AtomicRoland/BeebWiFi/doc/BeebWifi-UserManual.odt

BBC Micro WiFi

User Manual

Roland Leurs

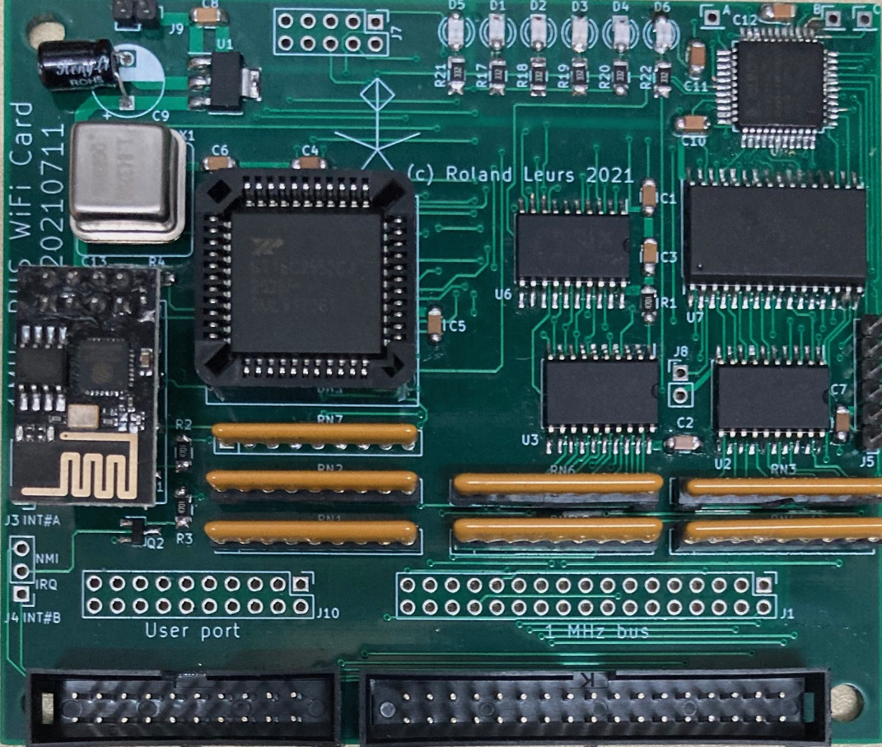
[picture p1: figure]

Copyright (c) 2021 - 2023 Roland Leurs

September 2023

# Introduction

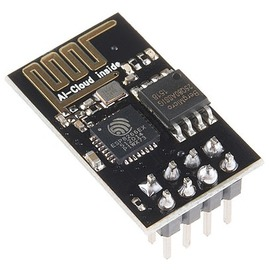
[picture p2: figure]

The ESP8266-01 is (literally) a small device with great possibilities. It enables classic computers and modern micro-controllers to connect to a WiFi network and transmit data via a simple serial interface. Just like bitd it accepts a set of AT commands and performs the necessary actions that are needed for the network communication. The device holds a complete TCP/IP stack, albeit IPv4 only.

So all you need to connect to a wireless network is just a standard serial interface, an ESP8266 and some software.

When I started this project on my Acorn Atom I used the serial port of the Godil and although it basically worked, data transfers were mostly not completed. I never figured out what the reason was, I still suspect my first ESP module (which was another type) was not quite good.

I decided to start a new project with another, even smaller, device (the one you see in the picture above) and I also added an extra serial device. For my Atom 2k18 I could use some additional serial ports since it needs one for communicating with the on-board Pi-Zero and now also for the WiFi device. I picked the 16C2552 which is a dual UART (Universal Asynchronous Receiver and Transmitter) which has two independent communication channels, a 16 byte input / output buffer (FIFO, first in first out) and can transmit up to 4 Mbps. And most important: it is affordable and available from reliable suppliers.

For the Atom I wrote a WiFi driver which can be used by user applications and commands. A basic set of commands include LAP (list access points), JOIN (join a network), TIME/DATE and WGET (to download a file from a web server). All these commands use the same driver. And this setup works nice.

About the time I finished this project the question “Acorn Electron online – any such hardware” popped up on the StarDot forum. And as I had such hardware and software for the Atom, I decided to port both to the Electron. The board was a great success and soon the request for a BBC (Master) version arose. After finishing most of the software for the Elk WiFi I started to work on a version that connects to the 1 MHz bus of the BBC Micro.

So here it is, the Beeb WiFi module. An easy to install and use board to connect your BBC Micro to the Internet. I hope you enjoy this device as much as I do.

# WARNINGS

Before I continue I have some important warnings:

### 1. Security

The BBC Micro is in no way a secure device, nor is the software for the WiFi module. When using the commands or driver, usernames and passwords may be kept in memory.

### 2. Baud rate changes may brick the ESP8266

The default transmission speed for the ESP8266 is 115,200 baud. Both the Atom and the BBC Micro can handle data transfers at this speed. Do not try to change this speed because the ESP8266 might accept your command but does not always perform it correctly. You might end up with a module that communicates at an unknown serial speed. The only remedy to fix that is to flash the device (or replace it, after all, they cost only about £1.00).

### 3. Only for personal, domestic use

Both the hardware and software are not designed for medical- and health use nor for mission critical, industrial and automotive purposes. Use it at your own risk.

# Hardware description

The complete diagram is included at appendix I. I will describe my design considerations and the components in this chapter.

### Design considerations

There were two options to make the WiFi board available to the BBC Micro:

1. Create an interface board that creates an Electron compatible slot for the Beeb.
2. Design a complete new board with the same core components.

Since the 1 MHz bus does not support sideways memory the ROM should always be installed on the main board or loaded from disc into sideways RAM. To meet the technical requirements of the 1 MHz bus, the first option adds extra costs to the WiFi connection. So I decided to make a new board that directly connects to the 1 MHz bus.

The same core components are used as in the Electron version:

- ESP8266 WiFi module
- 16C2552 Dual Channel UART
- 128 kB RAM
- Xilinx XC9572XL CPLD for logic
  The paged RAM register should be both writable and readable. I could do this by adding an extra buffer that is enabled when a read cycle occurs at &FCFF (the address of the paged RAM register). But the UART has two scratch pad registers. These behave like a normal memory address. So I use the scratch

pad register of the A-channel (which is available for generic serial applications) as a read/write copy of the paged RAM register. The decoding is simply done in hardware so for a programmer the address &FCFF is just a normal register that can be written and read.

If your BBC Micro already has paged RAM at &FDxx then you can disable the memory on the WiFi board by adding a jumper.

To use the full 128kB of the RAM I connected the Multi Function B output of the serial port to address line A16 of the RAM.

### Circuit description

The circuit has the following blocks:

1. Power supply The board gets its +5V from either the User Port (a connector is provided on the board) or you can connect an external power supply to J9. Only the power lines of the User Port are connected. No other pins are used by the WiFi board. A voltage regulator provides the necessary 3.3V.
2. CPLD: Control logic and level shifting The ESP8266 is a 3.3V device but it is connected to the UART which is a 5V device. This is no issue for the receiving line but the transmitting line must be converted from 5V to 3.3V. So the RX input of the ESP8266 is not directly connected to the UART but to the CPLD.  The CPLD also controls the RX and TX LEDs. Since the data transfer is quite fast, the human eye might miss some visual feedback. The CPLD is triggered by a level change at each RX and TX input and will light the according LED for 0.10 seconds.  The most important function of the CPLD is the control logic. Most inputs are directly taken from the 1 MHz bus connector and converted to the necessary control signals for accessing the devices on the board.
  Three unused pins of the CPLD are connected to extra pads on the board so they can be used for future features.
3. RAM The RAM CS, RD and WR signals are controlled by the CPLD. Address lines A0-A7 are also directly connected to the 1 MHz bus connector and A8-A15 are connected to the paged RAM register. A16 is connected to the MFB output of the UART to access the second bank of 64kB RAM.  Selecting a page is as easy as writing to the paged RAM register. After a (power on) reset the paged RAM register and the copy in Scratch Pad Register B are probably out of sync. Before using the paged RAM the program should synchronize these by simply writing a value to &FCFF.  The onboard RAM can be disabled by closing J8. This disables only the RAM, the paged RAM register is still in use, just like the shadow copy in the Scratch Pad Register.
4. UART: the serial device The UART is the interface between the CPU and the ESP8266. It has two independent channels. Channel A is unused by the WiFi board and can be used as a normal serial device. J7 has all the standard data and control signals plus an additional 5V. With a small extra interface you can directly connect a level converter for creating a real RS232 or RS432 interface. The Scratch Pad Register of channel A is used as a copy of the paged RAM register; Multi Function output A is fed into the CPLD for future features. Channel A is located at &FC38-&FC3F (hence the choice of SPR#A for the register copy: all lower address lines are ‘1’).  Channel B is exclusively used for the WiFi interface. The RX and TX lines are for data communication. The other modem control signals are also used: * DTR#B → enable/disable the ESP8266 * RTS#B → reset the ESP8266 * MF#B → extra address line for the paged RAM * RI#B → paged RAM status: enabled or disabled So it is possible to give the ESP8266 a real hardware reset, just in case it does not respond to any command. Just toggle the RTS line from high to low by writing a ‘1’ value to the corresponding bit in the modem control register. And of course, set is back to a high level by writing a ‘0’ to the modem control register. In a similar way it is also possible to disable the ESP8266. Just make the DTR output low by writing a ‘1’ to the corresponding bit in the modem control register. On a hardware reset of the UART this register is reset to all ‘0’ so the WiFi module becomes enabled again. To prevent this, you can write any value to the Line Status Register. This is unused in the UART device itself but it sets a flag inside the CPLD. This flag will prevent the CPLD to activate the RESET line to the UART. By writing any value to the Modem Status Register this flag will be cleared and reset signals are passed to the UART.
5. ESP8266 The module will be fitted as an add-on to the board. For optimal stability it is soldered directly to the board. Exchanging the ESP8266 will be a bit complicated so remember not to change the baud rate (see chapter ‘warnings’).

# Installation

Since the module is build and tested it is directly ready for use. Turn off your computer.

Remove the cover of your Micro and remove the bolts and nuts that hold the keyboard. Move the keyboard a little to get physical access to the expansion ROM sockets. Place the WiFi rom in one of the free sockets. Mind the orientation of the ROM! After installing the ROM, move the keyboard back to its place and tight it with the bolts and nuts. Reinstall the cover to your Micro.

Instead of installing the ROM you can also grab a copy of it from http://bbcmicro.nl/wifi/bbcwifi-latest.bin and load it into sideways RAM. Consult the manual of your RAM board for the exact syntax.

Connect the board with the two flat cables to the User Port and the 1 MHz bus and power on your BBC Micro. It should start with a banner like “BBC Micro WiFi”. A special WiFi symbol[^1] will be displayed whenever the module is enabled. If the WiFi symbol does not occur you can enable the WiFi module with the command

*WIFI ON

# Software

The ROM contains a set of new * commands and a driver for the ESP8266 module. In the next section I describe the new commands. The driver functions are described later in this manual. Please not that you cannot access the driver functions directly; there is an OSWORD call for accessing these functions from your own applications.

### DATE display date

Syntax: *DATE

This commands fetches the current date from the Internet by means of the NTP protocol. The driver does use the address ntp.time.nl for getting the date.

### DISCONNECT disconnect from a server

Syntax: *DISCONNECT

You can use this command to disconnect from a server if the connection stays open due to an error condition. Most commands do automatically close their connection to the server but sometimes they stay open. When you get a message “Already connected” you can use *DISCONNECT to close the connection.

To disconnect from a wireless network use *LEAVE.

### IFCFG display network information

Syntax: *IFCFG

Use this command to show the current assigned IP address and the MAC address of your ESP8266. This command cannot be used to manually set your IP configuration.

### JOIN connect to a wireless network

Syntax: *JOIN <ssid> [password]

In order to use the network functions you must first join a WiFi network. Use this command to join a network. The <ssid> is a required parameter. If you don’t supply a password on the command line then you will be prompted to enter the password. Please keep in mind that both the ssid and the password are case sensitive and that the password might remain in the computer’s memory!

If the ssid or the password of your network contains one or more spaces then you can put them between double quotes, like *JOIN “ACORN WIFI”. You can type a space when you are prompted for the password. If your network has no password then you can simply enter an empty string.

The command *JOIN ? will show you to what network you are currently connected to.

### LAP get a list of access points

Syntax: *LAP

This commands shows a list of access points. By default it shows this information for each access point:

+CWLAP:<ecn>, <ssid>, <rssi>, <mac>, <ch>, <freq offset>, <freq cali>

where

<ecn> = Encryption 0: OPEN, 1: WEP, 2: WPA_PSK, 3: WPA2_PSK,
4: WPA_WPA2_PSK

<ssid> = Network Id

<rssi> = Signal strength

<mac> = MAC address of access point

<ch> = Channel

<freq offset> = frequency offset of access point in KHz

<freq cali> = calibration for frequency offset

You can change this information with LAPOPT. The list of networks is always sorted by signal strength (rssi).

### LAPOPT set options for lap command

Syntax: *LAPOPT <option>

The option is a binary value with each bit representing what field will be shown when you use *LAP:

bit 0 sets whether <ecn> will be shown

bit 1 sets whether <ssid> will be shown

bit 2 sets whether <rssi> will be shown

bit 3 sets whether <mac> will be shown

bit 4 sets whether <ch> will be shown

bit 5 sets whether <freq offset> will be shown

bit 6 sets whether <freq calibration> will be shown

So, for example, *LAPOPT 7 will only show the encryption type, the name (ssid) and signal strength (rssi) of the available WiFi networks.

### LEAVE disconnect from current network

Syntax: *LEAVE

Disconnects you from the wireless network.

### MODE select operating mode

Syntax: *MODE <1...3>

The ESP8266 can operate as a WiFi station (client) or as an access point (server) or both. With the *MODE command you can select the operation mode:

1 → station mode

2 → SoftAP mode

3 → SoftAP and station mode

The mode is also stored into the device’s flash configuration and will remain until it is changed. When a new device is first powered on and it won’t respond to commands it is probably not configured as a station. Setting mode to 1 will solve that issue.

With *MODE ? you can query the current mode of the device.

### PING ping to a host

Syntax: *PING <host or ip-address>

You can test internet connectivity with this command or test whether a host is reachable. This command will send five “ping” packets and waits for the response from the remote host. When successful it will display the response time. If the host is not reachable then you will get a “No response from host” message. In case that the host does not exist or other failures you will see a “Host error” message.

### PRD dump contents of paged ram

Syntax: *PRD <address> <bank nr>PRD stands for “Paged RAM Dump”. This command is used to inspect the contents of the paged RAM. The address is a 16 bit value with the most significant byte being the page number and the least significant byte is the offset within the page. The bank number is either 0 or 1 and selects the bank that you want to dump. The

current bank number is always saved and restored after the dump command is finished. You can stop the dump by pressing the <ESC> key.

### PRINTER enable WiFi printing

Syntax: *PRINTER N:<printer name or ip-address>
*PRINTER S:baudrate,parity,data bits,stop bits
*PRINTER OFF

This command activates or stops the WiFi printer drivers. It’s still experimental so it might contain several bugs. See chapter “WiFi printing” for more information.

### REWIND reset UEF pointer

Syntax *REWIND

Resets the pointer of an UEF file to the beginning of the file. See chapter “Working with UEF files” for more information.

### SETSERIAL set up serial port A

Syntax: *SETSERIAL baudrate,parity,data bits,stop bits

The WiFi board has a dual port UART for general purpose usage. With this command you can setup the serial interface. Parameters are:

baudrate any (usual) baud rate between 300 and 115,200 baud
parity O(dd), E(ven), N(one), 1 or 0 sets the parity
data bits use 5, 6, 7 or 8 for the word length
stop bits use 1 or 2 for the number of stop bits

### TIME display current time

Syntax: *TIME

Like the *DATE command, you can also query the current time. See *DATE for additional information.

### TIMEZONE Sets UTC offset

Syntax: *TIMEZONE <offset from UTC>

This command sets the offset from the UTC to display date and time in the local time. The range is -12 to 14 hours. Fractional time offset are currently not supported. The abbreviation for this command is *TZ. Unlike the Electron version of the ROM, the UTC offset cannot be made persistent. You can however program your preferred default value in the ROM at address &BFFE when you have an EEPROM programmer.

### VERSION display firmware information

Syntax: *VERSION

This command retrieves the firmware version of the ESP8266 module.

### WGET retrieve a file from the Internet

Syntax: *WGET [-T X U A P S] <url> [load address]

This tool downloads a file from a web server and either displays it on the screen (for example a text file) or stores it in the Micro’s memory.

The tool has three parameters. The first one is an optional switch to indicate the file type. You may only specify one of these switches:

-T treat the file as a text file and display it on the screen after downloading the file. It will not be stored in the main memory.

-X this is the same as -T but it uses the code &0A as newline. Suitable to display Linux/Unix files.

-A the file will be downloaded into memory and has an ATM file header. If no load address is specified on the command line, the file will be stored on the load address in the header.

-P similar to the -A option, but now the file has an Atom-in-PC header. If no load address is specified on the command line, the file will be stored on the load address in the header.

-U the file is an UEF file. This file will be loaded into the second 64k bank of the paged RAM.

-S the file a a ROM file and will be loaded directly into sideways RAM. You should specify the RAM bank number (0 – F) as the last parameter; the default is bank 0.

The URL consists of a number of components:

protocol (required, http and https are supported
protocols)

hostname (required)

port number (optional)

path and filename (optional)

For example: http://acornlectron.nl:8080/path/to/file.htm

Although you can specify https as a protocol and the ESP8266 will connect to port 443 of the web server, it does not retrieve any data. This is probably related to either outdated encryption protocols or the ESP8266 might not support SNI.

The last parameter, load address, will override the load address that is in a header. If this parameter is omitted and the file has no header then it will be loaded at the current PAGE.

### WICFS Activate WiCFS

Syntax: *WICFS

WiCFS is an emulated cassette filing system using an UEF file as data source. This commands sets PAGE to &E00 and sets vectors FILEV, FSCV, FINDV and BGETV. See chapter “Working with UEF files” for more information.

### WIFI interface control

Syntax: *WIFI [ on | off | sr | hr ]

This command accepts one of these parameters:

on enables the WiFi device

off disables the WiFi device

sr performs a software reset of the ESP8266 by
issuing an AT+RST command

hr performs a hardware reset of the ESP8266 by
toggling the RTS line of the UART

# Driver functions

The communication with the ESP8266 is done with a few standard functions. So there is no need to use any of the AT commands in user applications. If you write an application that needs some features that are not in the driver then please report this and it can be added to the driver. This way we can assure compatibility whenever another WiFi device will be used.

The driver supports these functions[^2]:

Function | AT command | Short Description
00 | AT+RST | Initializes the ESP8266 (soft reset)
01 | n/a | Hard reset
02 | AT+GMR | Get firmware information
03 | AT+CWLAP | Get list of access points
04 | AT+CWJAP | Join access point
05 | AT+CWQAP | Quit access point
06 | Not implemented | Set access point parameters
07 | AT+CWMODE | Set device mode
08 | AT+CIPSTART | Connects to host
09 | AT+CIPMUX | Activate multiplex (up to five channels)
10 | Not implemented | List joined interfaces
11 | Not implemented | Set buffer address (old Atom driver)
12 | AT+CIPSTATUS | Get TCP/IP connection status
13 | AT+CIPSEND | Send data to remote host
14 | AT+CIPCLOSE | Close connection to remote host
15 | Not implemented | Set as server
16 | Not implemented | Set time out
17 | AT+CIOBAUD | Get baud rate (set baud rate is not implemented)
18 | AT+CIFSR | Get IP and MAC address
19 | Not implemented | Get firmware update
20 | IPD | Transfer data
21 | AT+CSYSWDTENABLE | Enable watchdog timer
22 | AT+CSYSWDTDISABLE | Disable watchdog timer
23 | n/a | Get multiplexer channel
24 | n/a | Enable/disable WiFi device
25 | AT+CWLAPOPT | Set options for LAP function
26 | AT+CIPSSLSIZE | Set SSL Buffer size
27 | AT+CIPMODE | Set transmission mode
28 | AT+PING | Perform ping command

### Function 00 Soft reset

Parameters: none

This function sends a software reset command to the WiFi device. The device will reinitialize itself.

### Function 01 Hard reset

Parameters: none

This function performs a hardware reset by toggling the RTS line from high to low and back to high.

### Function 02 Get firmware information

Parameters: none

This function retrieves the firmware version from the WiFi device.

### Function 03 Get list of access points

Parameters: none

This function retrieves a list of all wireless SSID’s in the neighborhood. The response is like:

+CWLAP:<ecn>, <ssid>, <rssi>, <mac>, <ch>, <freq offset>, <freq cali>

where

<ecn> = Encryption 0: OPEN, 1: WEP, 2: WPA_PSK, 3:
WPA2_PSK, 4: WPA_WPA2_PSK

<ssid> = Network Id

<rssi> = Signal strength

<mac> = MAC address of access point

<ch> = Channel

<freq offset> = frequency offset of access point in KHz

<freq cali> = calibration for frequency offset

See function 25 for LAP options. The ESP8266 might receive additional parameters for the AT+CWLAP command but these are not supported by this driver.

### Function 04 Join access point

Parameters: X points to the high byte of a parameter block

Y points to the low byte of a parameter block

The parameter block holds two adjacent strings which are terminated with a &0D byte. The first string is the SSID of the access point and the second string is the password for that access point. Both strings should not contain quotes and are case sensitive.

On success the WiFi device is connected to the wireless network and gets an IP address. This connection is permanently stored in the device so it connect automatically to this network after the next (power on) reset.

### Function 05 Quit access point

Parameters: none

This functions disconnects the WiFi device from the wireless network.

### Function 07 Set device mode

Parameters: X = hi byte param block

Y = low byte param block

The ESP8266 has three operation modes:

1 → station mode

2 → SoftAP mode

3 → SoftAP and station mode

Note that these values are not binary values but the ASCII values.

X and Y point to a parameter block in memory with the requested mode, terminated with &0D. If the parameter block is an empty string it will query the device for the current mode.

The mode is also stored into the device’s flash configuration and will remain until it is changed. When a new device is first powered on and it won’t respond to commands it is probably not configured as a station. Setting mode to 1 will solve that issue.

### Function 08 Connect to remote host

Parameters: X = hi byte param block

Y = low byte param block

The parameter block contains the following information, presented as strings terminated by &0D:

<link ID> (but only when multiplexing is active)

<type> (UDP, TCP or SSL)

<remote IP> (or hostname)

<remote port>

No quotes are allowed around these parameters. On success the device responds with CONNECTED crlf crlf OK crlf crlf. On failure it will respond with an error message, such as already connected or DNS failure etc.

### Function 09 Multiplexing control

Parameters: Y = multiplexing on (1) or off (0)

This function initializes the multiplex workspace for the driver and sends the multiplexer value to the ESP8266. This value might be both the ASCII value or the binary value.

### Function 13 Send data to remote host

Parameters: X points to data block in zero page

Y = channel (note to myself: this is not implemented yet!)

This data block holds two addresses:

- two bytes start address of data (low byte / high byte)
- two bytes length (low byte / high byte)

### Function 14 Close connection to host

Parameters: Y = channel (only when multiplexing is
active, otherwise ignored)

Some servers or services close the connection after responding to function 13. So it is advised to always call this function after a transfer has completed. If the connection is already closed by the server then this function will end with an error that might be ignored.

### Function 18 Get IP and MAC address

Parameters: none

This function retrieves the current IP address and MAC address of the ESP8266 device.

### Function 23 Get multiplexer channel

Parameters: none

You can use this function to request a free channel from the driver. Multiplexing must be enabled with function 09. This function responds with one of the following:

Carry cleared: Y = 255; multiplexing is switched off

Carry set: Y = 255: no free channel

Carry set: Y <> 255: assigned channel number

### Function 24 Enable/disable wifi device

Parameters: X = 0: disable WiFi, X = 1: enable WiFi

This function causes the UART to pull DTR low and so it disables the ESP8266. It also configures the CPLD to prevent that the UART is reset after pressing the BREAK key. So, if WiFi is disabled it will be disabled even after a (hard) reset. After a power off/power on reset it will be enabled again.

### Function 25 Set options for LAP function

Parameters: to be determined….

This sets the options which fields will be returned by the LAP function:

bit 0 sets whether <ecn> will be shown

bit 1 sets whether <ssid> will be shown

bit 2 sets whether <rssi> will be shown

bit 3 sets whether <mac> will be shown

bit 4 sets whether <ch> will be shown

bit 5 sets whether <freq offset> will be shown

bit 6 sets whether <freq calibration> will be shown

### Function 26 Set SSL Buffer size

Parameters: none

This function sets the SSL buffer size to a fixed value of 4096.

### Function 27 Set transmission mode

Parameters: X = hi byte param block

Y = low byte param block

UART-WiFi pass-through mode (transparent transmission) can only be enabled in TCP single connection mode or UDP of which remote IP and port won’t change (parameter <UDP mode> is 0 when using command "AT+CIPSTART" to create a UDP transmission).

During UART-WiFi pass-through transmission, if it is TCP connection and the TCP connection breaks, ESP8266 will keep trying to reconnect until "+++" is inputed to quit from transmission. After "+++",

please wait at least 1 second before sending next AT command.

If it is a normal TCP transmission and TCP connection breaks, ESP8266 will prompt " [<link ID>, ] CLOSED" , and won’t try to reconnect. Users can call "AT+CIPSTART" to create a connection again if it’s needed.

The parameter block contains a string holding the new mode; this is a single character string with a terminating &0D character:

Value 0: normal operating mode

Value 1: pass-through mode

Both values are the ascii characters for 0 and 1.

### Function 28 PING

Parameters: X = hi byte param block

Y = low byte param block

The parameter block contains a string with the hostname or an IP address of the host you want to ping. This string is terminated by &0D.

The result of the ping is one of the following:

+<time> the response time in ms

+timeout a time-out occurred

error a generic message that ping failed

### Function 29 Set time-out value

Parameters: X = time-out value

This function sets the duration of the time-out for function 13 (send data to remote server). Normally the default time-out is sufficient but some servers might take quite long to respond, such as api.openai.com (a.k.a. ChatGPT). From driver version 0.32 and up you can set the time-out value.

# Using the driver: OSWORD &65

Since you cannot access the WiFi driver functions directly, you can use this operating system call to get access to the driver.

Like any other OSWORD call the A register contains the function number (&65) and the X (lsb) and Y (msb) registers point to a parameter block. This parameter block is always three bytes and contains the parameters for the driver functions:

first byte: the driver function number (A)

second byte: the value for the X register

third byte: the value for the Y register

At return of this call the X register is stored at &F0 and the Y register at &F1 in version 0.32 (or higher) of the ROM.

Example:

You want to connect to a wireless network. So you store the ssid and password in memory at &680. The parameter block will be stored at &600.

To connect to the network do:

LDA #&04 \ load driver function

STA &600 \ write to first byte of driver parameter block

LDA #&06 \ load X value for function

STA &601 \ write to second byte of driver parameter block

LDA #&80 \ load Y value for function

STA &602 \ write to third byte of driver parameter block

LDX #&00 \ load X register with low byte of parameter block

LDY #&06 \ load Y register with high byte of parameter block

LDA #&65 \ load OSWORD function number

JSR &FFF1 \ do OSWORD call

# OSWORD API for time

To make it possible to use time in applications an API is provided to get the time. A OSWORD implementation is provided. To provide some sort of compatibility OSWORD 14 is implemented (Read Real-Time clock). Only function codes 0 and 1 are implemented. When calling this OSWORD function the A(ccu) should contain &0E (= 14).

On entry: XY?0=0 Return clock value as string
On exit: XY+0..24 CR-terminated string

On entry: XY?0=1 Return 7-byte BCD clock value
On exit: XY+0..6 7-byte BCD clock value

The date string format is "DDD,dd mmm yyyy.hh:mm:ss". The punctuation is normally irrelevant, the position of the component values is fixed.

# Working with UEF files

Unified Emulator Format (UEF) is a container format for the (un)compressed storage of audio tapes, ROMs, floppy discs and machine state snapshots for the 8-bit range of computers manufactured by Acorn Computers. First implemented by Thomas Harte's ElectrEm emulator and related tools, it is now supported by major emulators of Acorn machines. Martin Barr wrote UPCFS which is a tool that reads UEF files from a PC using an UPURS connection.

UEF attempts to concisely reproduce media borne signals rather than simply the data represented by them, the intention being an accurate archive of original media rather than merely a capability to reproduce files stored on them. A selection of metadata can be included, such as compatibility ratings, position markers, images of packaging and the text of instruction manuals. UPCFS only supports file data.

With WiCFS I ported UPCFS to the WiFi ROM. Only a few changes were necessary, mainly fetching the data from memory rather than from a serial connection.

### Downloading an UEF file

Before you can use an UEF file you have to download it from a (local) web server. Use the *WGET command for this with the -U switch, for example:

*WGET -u http://acornatom.nl/ddd.uef

This will download the UEF file and store it in the second bank of 64k paged RAM. At the moment only uncompressed files are supported. The uncompressed UEF should not exceed 65533 bytes (the last two addresses are used to store the length of the UEF file).

### Starting the WiCFS filing system

After loading the UEF file you can start the WiCFS filing system with the command:

*WICFS

This command activates *TAPE but changes the vectors FILEV, FSCV, FINDV and BGETV to its own routines. Commands like *CAT, *LOAD and *RUN are intercepted and redirected to the WiFi ROM. Page is set to &E00 as this is required for many games.

Also the read-pointer is reset to the beginning of the data.

### Rewinding

Just like a real tape you might sometimes need to “rewind” the data in memory. Of course we are not moving the data around but we have to move the read-pointer to the beginning of the data in memory.

After you have *CAT-ted an UEF file you must reset the read-pointer to the beginning of the file before you can load a file into the main memory of your computer. That’s all what the

*REWIND

command does.

### Tape analogies

To place a tape into the recorder: *WGET -U <url>

Switch on the tape recorder: *WICFS

Rewind the tape: *REWIND

Just like tapes, you might switch to another UEF file by issuing another WGET -U command. And just like real tapes you have to rewind it with *REWIND before accessing files otherwise you might get read errors.

You can compare the read-pointer at the UEF with the tape position just below the magnetic head of your cassette recorder.

# Printing with the WiFi board

The WiFi board has two interfaces to connect a printer:

1. The serial port A of the UART
2. The network interface

Keep in mind that modern printers need both a CR and LF for a new line. Old dot matrix printers often needed only CR. To enable a line feed use the command *FX 6,0

### Connecting a serial printer

To connect a serial printer you need an additional adapter to convert the TTL logic signals to real RS-232 levels in both directions. The serial port on the board has a +5V pin for this purpose. Such a conversion board is not covered in this manual.

To enable the serial printer you start with the command:

*PRINTER S:<baud rate>,<parity>,<data bits>,<stop bits>

where

baud rate any (usual) baud rate between 300 and 115,200 baud
parity O(dd), E(ven), N(one), 1 or 0 sets the parity
data bits use 5, 6, 7 or 8 for the word length
stop bits use 1 or 2 for the number of stop bits

This command only enables the printer driver but it does not select the serial printer. To select the serial printer you use the *FX 5,6 command. The number 6 is the hard coded printer ID in the WiFi ROM for both the serial and network printer. After you selected the serial printer you can start printing with VDU 2 (or CTRL+B) and stop printing with VDU 3 (or CTRL+C).

The serial printer drivers is not tested and lacks any kind of handshake. It simply outputs all the data to the serial port and the printer should be able to receive and buffer the data. For fast printers or printers with a large buffer this won’t be an issue, but a slow dot matrix printer might suffer data loss.

If you need any kind of handshake, we’ll have to add it to the driver. Both software handshake with XON/XOFF and hardware handshake with CTS/RTS can be implemented.

### Printing to a network printer

To use a network printer you need a printer that is compatible with the HP JetDirect interface. Most Hewlett Packard network enabled printers have such an interface but also many other manufacturers have printers with a compatible interface.

This interface accepts raw data and will print in a standard courier font. By sending the appropriate PCL commands you can also use more advanced features of your printer. PCL is not covered in this manual.

Printing over SMB (for printing to a shared printer on a Windows host) or LPD is not supported; printing goes directly to the network attached printer.

Before you can print to a network printer you have to enable the printer driver with:

*PRINTER N:<printer name or IP address>

This command only enables the printer driver but it does not select the network printer. To select the network printer you use the *FX 5,6 command. The number 6 is the hard coded printer ID in the WiFi ROM for both the serial and network printer. After you selected the network printer you can start printing with VDU 2 (or CTRL+B) and stop printing with VDU 3 (or CTRL+C).

While printing the ESP8266 module is put into pass-through mode. Every byte received over the serial interface is directly passed on to the network. A disadvantage of pass-through mode is that it is not supported with multiplexing active. So you cannot use the WiFi commands during printing. If the printer is not active, the WiFi command can be used.

So, this won’t print the book of Winnie the Pooh:

*PRINTER N:OKI.RLS.TRIPPLER.NL
*FX 5,6
VDU 2
*WGET -X http://bbcmicro.nl/winnie-the-pooh.txt
VDU 3

### Disable the printer driver

To disable the printer driver, simply type: *PRINTER OFF

# WiDFS

WiDFS is a separate ROM that operates independently from the WiFi ROM. This ROM enables you to mount a DFS image on a web server or NAS storage over HTTP. With a little supporting PHP script and a modification in the .htaccess file of an Apache web server you can even mount an image in read/write mode.

The temporary storage of received data and the WiDFS workspace are stored in paged RAM bank 1. So PAGE remains at &E00. There’s also a cached copy of each catalogue in this workspace. You can mount up to four images at the same time and access them as drive 0 … 3. Every read operation on the catalogue is performed on the cached copy to improve speed. When you read data from the virtual disc the complete block of data is first downloaded into the paged RAM buffer and later copied to the destination RAM, either into the lower memory area or into one of the file buffers in the paged RAM.

### Installation

Although the WiFi ROM and WiDFS ROM operate independently from each other you need to update WiFi ROM to version 0.26 or higher. This version solves some conflicts in zero page usage and other memory areas.

After the update you can download the WiDFS ROM into sideways RAM with the *WGET -S command:

*WGET -S HTTP://BBCMICRO.NL/WIDFS/WIDFS.ROM 2

(replace the number 2 by an available sw ram bank number !)

Press break

### Mounting and dismounting an image

Before you can access an image you will need to mount it. The syntax of the mount command is:

*MOUNT <drv> <url>

where <drv> is the drive number in the range from 0 to 3 and <url> is the location on the web server or your storage device. During the mount process the file is opened and the first 512 bytes are downloaded, assuming this is the catalogue. The current version does not check if the mounted images is really a DFS image.

Use *UMOUNT <drv> to unmount a disc image. Using *MOUNT without parameters will show you a list of the four virtual drives and the mounted images for each drive.

After the image is mounted you can use most of the regular DFS commands to access files. Commands for disc management (like compact, copying, formatting and verifying) are not supported.

### Write access to an image

In most cases you will only need read access, especially when your images are stored on a public web server. But you can make these images writeable with a little extra configuration.

Step one: install the ssdwrite.php script on your web server

$headers = apache_request_headers();

$file = basename($_SERVER['REQUEST_URI']);

$fh = fopen($file, 'rb+');

if ($fh) {

if (isset($headers['X-Write-Range'])) {

$range = preg_split('/=/', $headers['X-Write-Range']);

list($start, $end) = preg_split('/-/', $range[1]);

$length = intval($end) - intval($start);

fseek($fh, $start, SEEK_SET);

fwrite($fh, $data, $length);

header('X-Write-Status: 0 OK');

} else {

header('X-Write-Status: 1 ERROR Missing or invalid range');

header('Content-length: 512');

$fh = fopen($file, 'rb');

echo fread($fh, 512);

}

fclose ($fh);

} else {

header('X-Write-Status: 2 ERROR not writable');

header('Content-length: 512');

$fh = fopen($file, 'rb');

echo fread($fh, 512);

fclose ($fh);

}

} else {

header('X-Write-Status: 3 ERROR not file');

}

This is a very basic version of the script. You can download the complete file from https://bbcmicro.nl/WIDFS/ssdwrite.tgz

Step two: modify the .htaccess file on your web server. Add the following lines:

RewriteEngine On

RewriteCond %{REQUEST_METHOD} POST

RewriteRule . ssdwrite.php [L]

After you have configured your web server the *MOUNT command will automatically detect the read/write status of the image and mount it accordingly. Various commands will check the mount status before doing their job and throw an error if the image is not writeable.

Some notes on access control:

1. To prevent abuse of the ssdwrite script it is strongly advised to rename this to a random name like regiuzfots.php or whatever. Use this name also in your .htaccess file.
2. By default the only access control is the web host file system access control. You can make the image read only by removing the write permissions. This is only necessary when you are mixing both writeable and read-only images in one directory.
3. Feel free to play with Allow and Deny directives in your .htaccess file to grant read or write permissions to public users. You can also add some IP based access control in the PHP script so that some users have write access to the images and others will only be able to read the images.

A word about the performance

You will notice that the read performance is quite good. Games like Elementum, Manic Miner and Electrobots will load within a few seconds. For each disc access there’s one request to the web server because the catalogue is cached.

Writing to an image is quite slow. This is because each write request needs to update the catalogue and the data in the image. These are two requests to the web server. Besides that, the uploaded file data has to be split in chunks of 2 kB. This is a requirement of the ESP8266 module.

### Storage capacity

WiDFS is based on Acorn’s DFS, so you can have up to 31 files in an image. The maximum sector number is &3FF (1023) and each sector can hold 256 bytes. So the maximum disk image size is 262,144 bytes (256 kB). You are not restricted to the limits of physical discs, like 100 or 200 kB.

The file length field for each file is 18 bits. This makes the maximum file length 261,632 bytes. Thats almost 256 kB because the first 512 bytes of the disk image are reserved for the catalogue.

### Known issues with WiDFS

In the current version there are some limitations:

- Your web server needs to support partial HTTP requests; most modern web servers do support them.
- Write access is (probably) limited to Apache because of using the .htaccess files. On other web server software like NGINX, LightHTTP, IIS etc you will have to figure out how to redirect POST requests to the PHP script.
- The software has not been tested in coexistence of any other physical disc system. It is certainly not possible to copy images to discs or the other way round with the current software.
- The TUBE or any other second processor are also not supported yet. Since WiDFS is based on AcornDFS and RamFS (Datacentre) it is likely that a future version will have support support for a second processor.
- Please note that both WiCFS (for reading UEF files) and WiDFS both use paged RAM bank 1 and thus they cannot be used at the same time. Loading an UEF file will destroy your disc images without warning.
- Do not store personal information in disc images on a public web server. Both the communication and the storage lack any way of encryption!

Some images to start with are:

HTTP://BBCMICRO.NL/WIDFS/ATMAN.SSD

HTTP://BBCMICRO .NL/WIDFS/ELECTROBOTS.SSD

HTTP://BBCMICRO .NL/WIDFS/ELEMENTUM.SSD

HTTP://BBCMICRO .NL/WIDFS/MANICMINER.SSD

HTTP://BBCMICRO .NL/WIDFS/OUTBREAK.SSD

HTTP://BBCMICRO .NL/WIDFS/TESTIMG.SSD

You can mount the last image in read-write mode.

# Appendix I: circuit diagram

# Appendix II: compatibility

This cartridge is tested with a BBC Micro with a Palesar 256 kB RAM expansion board and a Watford DFS disc drive interface.

Known issues:

- The Tube and Econet interface are not tested with the WiFi board and ROM. They probably won’t work correctly together.
- Not all games are compatible with WiCFS. A list of known working games is at: https://www.retro-kit.co.uk/page.cfm/content/UPCFS-Working-titles/

You can send your feedback to: roland@acornatom.nl

# Appendix III: Memory usage

The hardware uses the following addresses in the BBC Micro memory map:

&FC30-&FC37 UART Port B (used by WiFi)

&FC38-&FC3E UART Port A (available to user)

&FC3F read back of paged RAM register

&FCFF paged RAM register

&FD00 - &FDFF paged RAM

The software uses the following addresses:

&0090 - &0096 permanent storage in page 0

&00B0 - &00CF temporary workspace in page 0

&0100 - &0140 temporary workspace for error handling

&0398 - &03FF used by WiCFS

&07A4 - &07FF used by WiCFS

&0900 - &0AFF temporary workspace for WiFi commands

&8000 - &BFFF sideway ROM or RAM

# Appendix IV: License

The license for this Work (i.e. both the hardware and software) are simple:

1. You have the right to use the Work in any way you want for non-commercial use. Commercial use is considered when you integrate the Work into your own products or replicate the Work and sell it.
2. You may create your own hardware and software based on the Work for non-commercial use. However, for deviated projects you must use the same license.

Warranties and Disclaimer

Except as required by law, the Work is licensed by the Licensor on an "as is" and "as available" basis and without any warranty of any kind, either express or implied.

Limit of Liability

Subject to any liability which may not be excluded or limited by law the Licensor shall not be liable and hereby expressly excludes all liability for loss or damage howsoever and whenever caused to You.

[^1] If your BBC computer starts in mode 7 then a ^ symbol is shown.
[^2] Well, supports almost all of these functions. Some functions are not implemented yet.
