AtomicRoland/BeebWiFi/doc/BeebWifi-schema.pdf

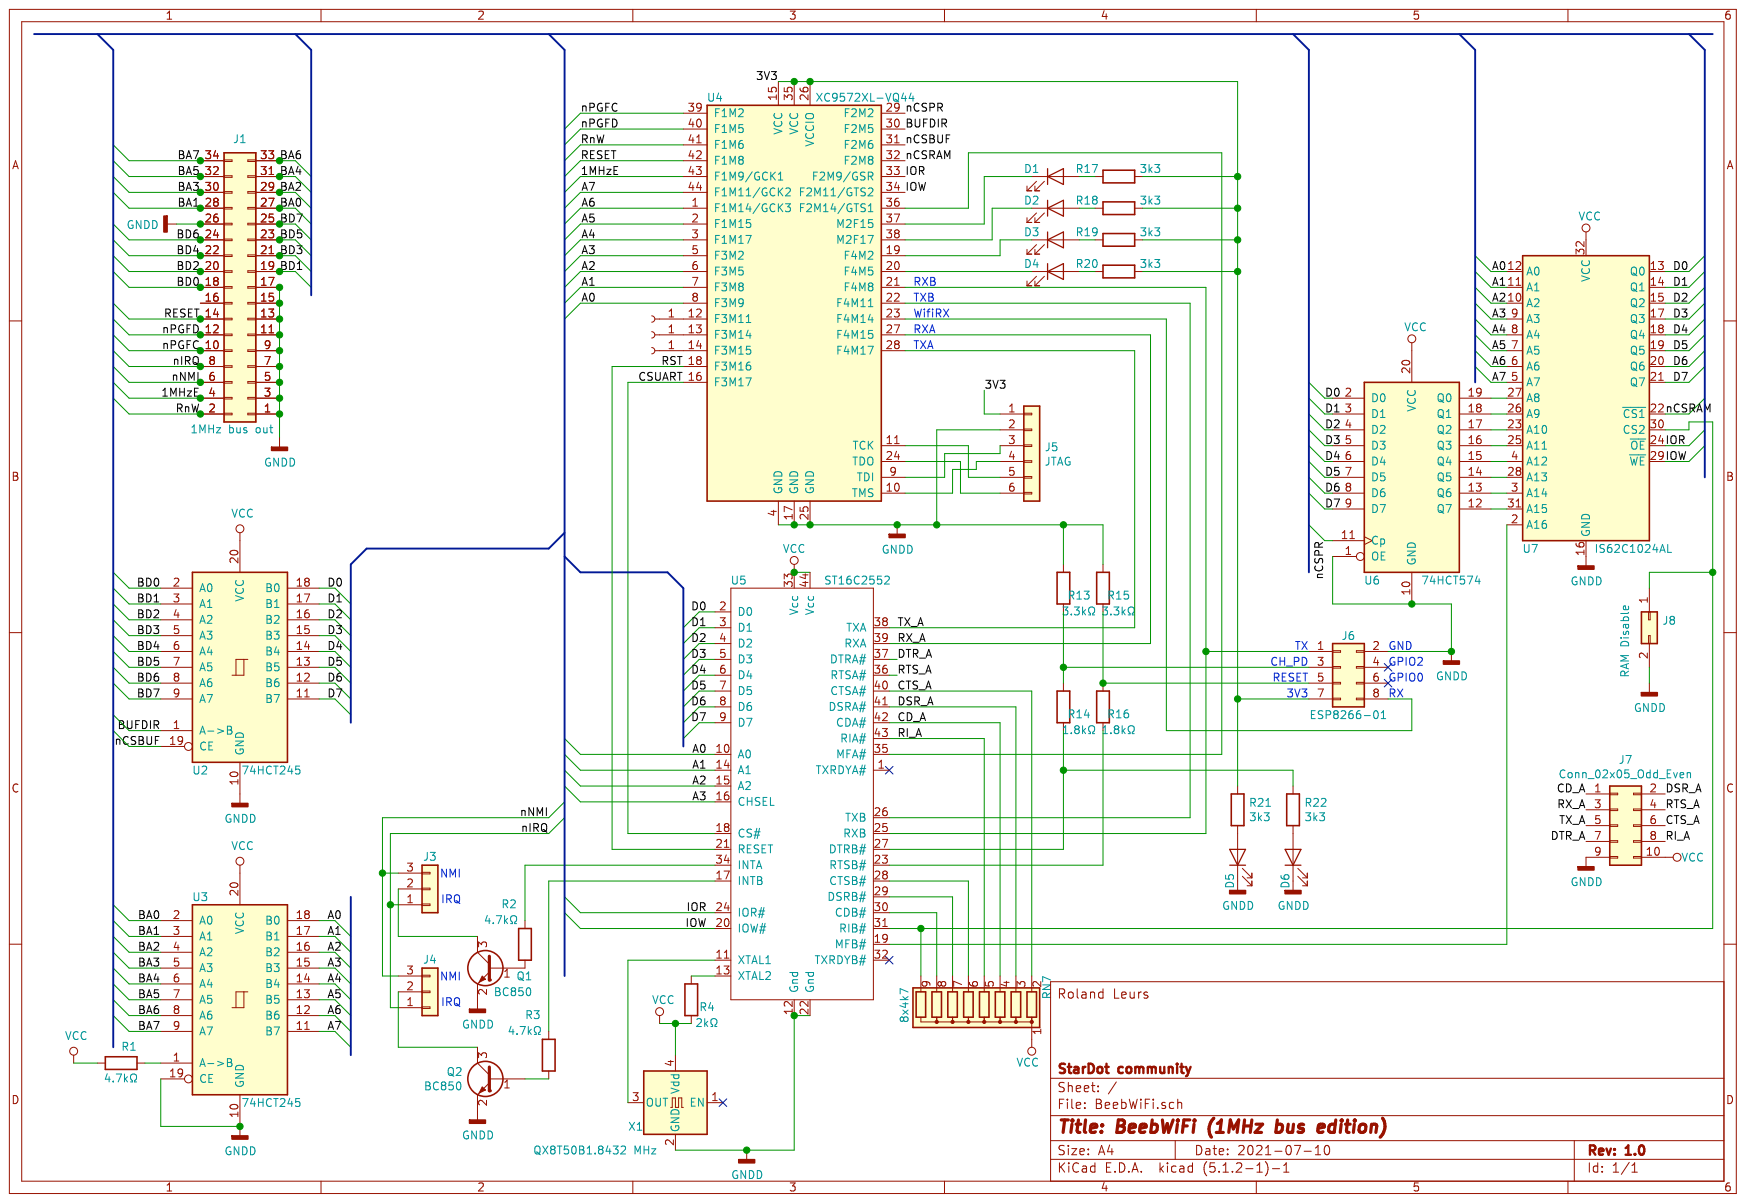
[picture p3: page 1]
