AtomicRoland/BeebWiFi/rom/wget.asm

\ WGET command
\ Syntax:    *WGET [-T | -X | -A | -P | -U | -S | -F] <url> [address]
\ Option:    -T        optional    print the downloaded file directly on the screen, newline by &0D
\            -X        optional    print the downloaded file directly on the screen, newline by &0A
\            -A        optional    the file has an ATM header
\            -P        optional    the file has an Atom-in-PC header
\            -U        optional    the file is a UEF file
\            -S        optional    the file is a sideways rom, specify banknumber in address parameter
\            -F        optional    force file to load in host if second processor present
\            url       required    the url of the file, including http(s)://
\            address   optional    load address of the file
\ The address will override the load address in the ATM header (if any). It will be ignored with the -T parameters since that option
\ does not store any contents in memory. If the file has no ATM header the address is required.
\ 
\ (c) Roland Leurs, July 2020

                fflag = heap + &F4      \ 1 byte as tube transfer flag, 0= host transfer, &FF=tube transfer
                proto = heap + &F5      \ 1 byte
                newln = heap + &F6      \ 1 byte
                clptr = heap + &F7      \ 1 byte
                index = heap + &F8      \ 1 byte
                sflag = heap + &F9      \ 1 byte
                tflag = heap + &FA      \ 1 byte
                aflag = heap + &FB      \ 1 byte
                pflag = heap + &FC      \ 1 byte
                uflag = heap + &FD      \ 1 byte
                laddr = heap + &FE      \ 2 bytes

                tubeflag = &27A         \ (Osbyte &EA = 0 if no tube, &FF if tube)
                tubereg  = &FCE5        \ address of tube data transfer register on electron
                tubeID   = &E0          \ a number between &C0 and &FF that is my ID for claiming tube interface
                                        \ needs to be sent with bit 6 = 0, ie. between &80 and &BF to release tube
                                        \ unless a run command 4 has been sent

.wget_cmd                   \ start wget command
 lda tubeflag               \ fflag will be &FF if tube present, unless cleared later
 sta fflag
 lda #0                     \ initialize flags and address
 sta tflag
 sta sflag
 sta aflag
 sta pflag
 sta uflag
 sta proto                  \ default no ssl (i.e. http)
 sta laddr
 sta laddr+1
 lda #&0D                   \ set new line character
 sta newln                  \ can be overwritten by -U flag

.wget_l1
 jsr skipspace1             \ forward Y pointer to first non-space character
 jsr read_cli_param         \ read first parameter from command line
 cpx #&00                   \ test if any parameter given, x will be > 0
 bne wget_read_params       \ continue if one parameter is on the command line
 jsr printtext              \ no parameter, print a message
 equs "Usage: WGET [-TXAPUSF] <url> [address]",&0D,&EA
 jmp call_claimed           \ end of command

.wget_read_params
 lda strbuf                 \ read first character of the parameter
 cmp #'-'                   \ check for a dash
 bne wget_read_uri          \ it's not a dash so we consider it the url
 lda #0                     \ clear fflag when other flags (including F) set to prevent tube transfers
 sta fflag

 lda strbuf+1               \ read character of option
 ora #&20                   \ convert to lowercase
 cmp #'f'                   \ check for F (force host load- already cleared above)
 beq wget_l1
 cmp #'t'                   \ check for T (text file)
 beq wget_option_t          \ jump if T
 cmp #'a'                   \ check for A (ATM header)
 beq wget_option_a          \ jump if A
 cmp #'x'                   \ check for X (unix text file)
 beq wget_option_x          \ jump if X
 cmp #'p'                   \ check for P (Atom-in-PC header)
 beq wget_option_p          \ jump if P
 cmp #'u'                   \ check for U (UEF file)
 beq wget_option_u
 cmp #'s'                   \ check for S (Sideway rom)
 beq wget_option_s
 ldx #(error_bad_option-error_table)
 jmp error                  \ unrecognized option, throw an error

.wget_option_x              
 lda #&0A                   \ load alternative new line character
 sta newln                  \ write to workspace
.wget_option_t
 lda #1                     \ set flag to 1
 sta tflag
 bne wget_l1                \ jump always

.wget_option_a
 lda #1                     \ set flag to 1
 sta aflag 
 jmp wget_l1                \ jump always

.wget_option_p
 lda #1                     \ set flag to 1
 sta pflag
 jmp wget_l1                \ jump always (branching is too far)

.wget_option_u
 lda #1                     \ set flag to 1
 sta uflag
 jmp wget_l1                \ jump always (branching is too far)

.wget_option_s
 lda #1                     \ set flag to 1
 sta sflag
 jmp wget_l1                \ jump always (branching is too far)

.wget_read_uri              \ the parameter is not an option switch, treat it like a url
 sty clptr                  \ save command line pointer
 lda strbuf                 \ very primitive check for http(s)
 ora #&20                   \ convert to lower case
 cmp #'h'                   \ check for 'H'
 beq wget_read_uri_l1       \ jmp if an 'H'
.wget_protocol_error
 ldx #(error_bad_protocol-error_table)
 jmp error                  \ unsupported protocol, throw an error

.wget_read_uri_l1
 ldx #4                     \ preset my pointer
.wget_read_uri_l1a
 lda strbuf,x               \ check if 5th character is either an S or :
 cmp #':'                   \ check for ':'
 beq wget_read_uri_l3       \ it's a :, go check for the two slashes
 ora #&20                   \ convert to lower case
 cmp #'s'                   \ check for 's'
 beq wget_read_uri_l2       \ it's a s, set protocol to https and go check for two slashes
 bne wget_protocol_error    \ looks like an unsupported protocol to me

\ Set protocol in heap
.wget_read_uri_l2
 lda #4                     \ set ssl/https flag
 sta proto
 inx                        \ increment pointer
 bne wget_read_uri_l1a      \ jump always
.wget_read_uri_l3
 inx                        \ increment pointer
 lda strbuf,x               \ load character
 cmp #'/'                   \ check for first slash
 bne wget_protocol_error    \ jump if not slash
 inx                        \ increment pointer
 lda strbuf,x               \ load character
 cmp #'/'                   \ check for second slash
 bne wget_protocol_error    \ jump if not slash
 ldy #0                     \ reset pointer
 stx index                  \ save pointer to string buffer
 ldx proto                  \ load index to protocol table
.wget_read_uri_l4
 lda protocols,x            \ load character
 sta heap,y                 \ write to heap
 inx                        \ increment index
 iny                        \ increment pointer
 cmp #&0D                   \ test for end of string
 bne wget_read_uri_l4

 \ Copy the hostname to the start of the string buffer 
 ldy #0                     \ reset pointer
 ldx index                  \ restore pointer to string buffer
 inx                        \ increment pointer to start of hostname
.wget_read_uri_l4a
 lda strbuf,x               \ load character
 cmp #' '                   \ check for space
 beq wget_read_uri_l5       \ if it's space, jump to end of hostname copy
 cmp #':'                   \ check for colon
 beq wget_read_uri_l5       \ if it's colon, jump to end of hostname copy
 cmp #'/'                   \ check for slash
 beq wget_read_uri_l5       \ if it's colon, jump to end of hostname copy
 cmp #&0D                   \ check of end-of-input
 beq wget_read_uri_l5       \ if it's the end, jump to end of hostname copy
 sta strbuf,y               \ store the character in the string buffer
 iny                        \ increment pointers
 inx
 bne wget_read_uri_l4a      \ jump for next character
.wget_read_uri_l5
 pha                        \ save the character
 lda #&0D                   \ load end-of-string
 sta strbuf,y               \ terminate the string
 stx index                  \ save pointer to string buffer
 ldx #4                     \ load pointer to heap (just behind the procol string)
 jsr copy_to_heap           \ copy the hostname to the heap
 stx save_y                 \ save heap index
 ldx index                  \ restore string buffer pointer
 pla                        \ get character back
 cmp #':'                   \ test for colon
 bne wget_read_uri_l8       \ jump if no colon (meaning there is no port specified)

\ Copy the port number from the string buffer to the heap
 ldy save_y                 \ restore heap index
.wget_read_uri_l6
 inx                        \ increment pointer
 lda strbuf,x               \ load character of port
 cmp #' '                   \ test for end of port number, either space, slash or CR
 beq wget_read_uri_l7
 cmp #'/'
 beq wget_read_uri_l7
 cmp #&0D
 beq wget_read_uri_l7
 sta heap,y                 \ write to heap
 iny                        \ increment pointer
 bne wget_read_uri_l6       \ jump if there are more characters
.wget_read_uri_l7
 stx index                  \ save pointer to string buffer (start of filespec)
 lda #&0D                   \ terminate port number
 sta heap,y
 bne wget_open_connection   \ jump always

\ Copy the default port numbers to the heap 
.wget_read_uri_l8
 ldx proto                  \ load index to protocol table
 ldy save_y                 \ restore heap index
.wget_read_uri_l9
 lda ports,x                \ load character
 sta heap,y                 \ write to heap
 inx                        \ increment index
 iny                        \ increment pointer
 cmp #&0D                   \ test for end of string
 bne wget_read_uri_l9       \ jump if string not copied yet

\ Now the first three parameters are on the heap:
\ protocol, hostname and port number
\ We can now fire the CPstaRT command
.wget_open_connection
 lda proto                  \ load protocol
 beq wget_open_l1           \ jump if tcp
 lda #26                    \ load Wifi command
 jsr wifidriver             \ Init SSL Buffer

.wget_open_l1
 ldx #>heap                 \ load heap address into registers x and y
 ldy #<heap
 lda #8                     \ send "open" command 
 jsr wifidriver
 lda pageram+&B             \ check for OK response (Normal response is: CONNECT crlf crlf OK crlf crlf)
 cmp #'O'
 bne wget_open_err          \ It's not OK, so throw an error
 lda pageram+&C             \ check second character, just to be sure
 cmp #'K'
 beq wget_build_get         \ It's OK, continue
.wget_open_err
 jsr reset_buffer           \ reset buffer pointer to print error message from device
 jsr print_string           \ print error string
 ldx #(error_opencon-error_table)
 jmp error

.wget_build_get
\ Build the GET command
 ldy #0                     \ reset pointer to heap
 ldx #0                     \ reset index
.wget_get_l1
 lda getcmd,x               \ load character from GET command
 sta heap,y                 \ write to heap
 inx
 iny
 cpx #5                     \ test for end of string
 bne wget_get_l1

\ Copy file spec to heap
 ldx index                  \ restore the index to string buffer (filespec)
 lda strbuf,x               \ check if there is no filespec, eg http://stardot.org.uk
 cmp #&0D                   \ is hostname terminated with CR
 beq wget_get_l3a           \ if yes then don't copy the filespec
 inx                        \ increment pointer to first character of filespec
.wget_get_l2
 lda strbuf,x               \ load character
 sta heap,y                 \ write to heap
 inx                        \ increment buffer index
 iny                        \ increment heap pointer
 cmp #' '                   \ test for end of filespec
 beq wget_get_l3
 cmp #&0D                   
 beq wget_get_l3
 bne wget_get_l2            \ if not end of filespec then jump for next character
.wget_get_l3
 dey                        \ decrement heap pointer to overwrite the CR
 stx index                  \ save string buffer index
.wget_get_l3a
 ldx #0                     \ reset index
.wget_get_l4
 lda http11,x               \ load character from http header
 sta heap,y                 \ write to heap
 iny                        \ increment heap pointer
 inx                        \ increment buffer index
 cpx #17                    \ compare to string length
 bne wget_get_l4            \ jump if characters left

\ Copy host to heap
 ldx #0                     \ reset index
.wget_get_l5
 lda strbuf,x               \ load character from hostname (it was copied to the beginning of string buffer)
 sta heap,y                 \ write to heap
 iny                        \ increment heap pointer
 inx                        \ increment buffer index
 cmp #&0D                   \ test for end of hostname
 bne wget_get_l5            \ jump if characaters left

\ Copy rest of http header to heap
 dey                        \ decrement heap pointer to overwrite the CR
 ldx #0                     \ reset index
.wget_get_l6
 lda user_agent,x           \ load character
 beq wget_load_address      \ stop copying if the string is ended
 sta heap,y                 \ write to heap
 iny                        \ increment heap pointer
 inx                        \ increment buffer index
 bpl wget_get_l6            \ jump if characaters left, limited to 128 characters

\ Now read the load address
.wget_load_address
 sty save_y                 \ save the header length
 ldx index                  \ restore index to string buffer
 ldy clptr                  \ restore pointer on command line
 jsr skipspace1             \ read next character
 jsr read_cli_param
 cpx #0                     \ test if no parameter
 beq wget_send_l1           \ jump if no address was given
 ldx #zp                    \ load zero page address where parameter will be stored
 jsr string2hex             \ convert to hexadecimal value
 lda zp                     \ copy to my workspace
 sta laddr
 lda zp+1
 sta laddr+1
 lda laddr

\ Set parameters for CIPSEND command
.wget_send_l1
 lda fflag                  \ but first check if tube transfer
 beq wget_send_l1a          \ if fflag is set (other flags will be 0)      
 lda laddr                  \ get load address and initiate tube here to avoid loss of data while tube starts
 ora laddr+1
 bne wget_claim_tube        \ yes, there is a load address so jump
 lda #8                     \ default to PAGE (&800 in second processor)
 sta laddr+1
.wget_claim_tube
 lda #tubeID                \ claim tube interface
 jsr &406
 bcc wget_claim_tube
 ldx #LO(laddr)
 ldy #HI(laddr)
 lda #1
 jsr &406                   \ set up tube for write operation

.wget_send_l1a
 ldx #data_counter          \ load pointer to zeropage
 lda #<heap                 \ set start of heap in zeropage
 sta &00,x
 lda #>heap
 sta &01,x
 lda save_y                 \ load header length
 sta &02,x                  \ store in zeropage
 lda #&00
 sta &03,x
 sta &04,x
 lda #13                    \ load driver command
 jsr wifidriver             \ send the header
 stx datalen                \ store end of data block
 lda pagereg
 sta datalen+1

\ Process received data
.wget_copy_received_data
 jsr reset_buffer           \ reset pointer to recieve buffer (PAM)
 jsr wget_search_ipd        \ search IPD string
 bcs wget_crd_l0            \ jump if string found
 jmp wget_crd_end           \ end if no IPD string found 
.wget_crd_l0
 jsr wget_read_ipd          \ read IPD (= number of bytes in datablok)
 jsr wget_http_status       \ check for HTTP statuscode 200
 jsr wget_search_crlf       \ search for newline

 \ Some webservers, like the Python SimpleHTTP send the HTTP header in a separate
 \ ethernet frame. So we must check here if the block length of the first +IPD has
 \ become zero or negative. The maximum block length is about 1470 bytes.
 lda blocksize+1            \ check if block size is negative
; php:jsr printhex:jsr osnewl:plp
 bmi wget_reread_ipd        \ jump if negative to read the new IPD
 jsr read_ipd_end           \ check if block size is zero
 bne wget_check_flags       \ if not zero then continue 
.wget_reread_ipd
 jsr wget_search_ipd        \ else search next IPD string
 bcs wget_reread_ipd2
 jmp wget_crd_end           \ end if no IPD string found 
.wget_reread_ipd2
 jsr wget_read_ipd          \ read IPD (= number of bytes in datablok)
 jsr wget_search_crlf       \ search end of response headers

 \ Check the header flags -A (ATM) and -P (Atom-in-PC or APC); the first has presendence when both are given.
.wget_check_flags
 lda aflag                  \ test if ATM header option given
 bne wget_atm_header        \ jump if there's no -A flag
 lda pflag                  \ test if APC header option given
 beq wget_set_load_addr     \ skip reading the header if no APC header (pflag = 0)
 jsr wget_read_apc_header   \ read the APC header
 jmp wget_set_load_addr     \ jump always

.wget_atm_header
 jsr wget_read_atm_header   \ read the ATM header

.wget_set_load_addr
 lda laddr                  \ check if there is a load address by now
 ora laddr+1
 bne wget_set_load_addr_l1  \ yes, there is a load address so jump
 jsr wget_set_default_load  \ otherwise set the default load address (PAGE on Electron, ?#12 on Atom)
.wget_set_load_addr_l1
 lda uflag                  \ is it an UEF file?
 beq wget_set_load_addr_l3  \ no, then jump to store the load address in zero page
 ldy #0                     \ reset pointer to paged RAM
.wget_set_load_addr_l2
 sty pr_r                   \ set "second page register"
 ldy #0                     \ reset pointer to paged RAM (necessary if S flag set!)
 sty pr_y                   \ set "second page pointer"
 sty sbufl                  \ reset tape length counter
 sty sbufh
 beq wget_crd_loop          \ jump always
.wget_set_load_addr_l3
 ldy #&20                   \ load SW ROM files from page &20 to save WiDFS work space
 lda sflag                  \ is it a SW ROM file?
 bne wget_set_load_addr_l2  \ if so, treat it like an UEF file
 lda laddr                  \ copy load address to zero page
 sta load_addr
 lda laddr+1
 sta load_addr+1
 
.wget_crd_loop              \ copy received data
 lda tflag                  \ check for X or T-flag (if set, dump data to screen)
 bne wget_dump_data
 lda uflag                  \ check for U-flag (if set, keep data in paged RAM)
 bne wget_read_uef_data 
 lda sflag                  \ check for S-flag (if set, also keep data in paged RAM)
 bne wget_read_uef_data 
 jsr wget_read_http_data    \ read received data block
 jmp wget_crd_l1            \ jump for next block
.wget_dump_data
 jsr wget_dump_http_data    \ print received data block
.wget_crd_l1
 jsr wget_test_end_of_data  \ test if this was the last block
 bcc wget_crd_end
 jsr wget_search_ipd        \ search for next IPD
 bcc wget_crd_end           \ jump if no more blocks found
 jsr wget_read_ipd          \ read the block length
 jmp wget_crd_loop          \ read this block
.wget_crd_end
 lda fflag
 beq wget_crd_end2          \ if fflag is set need to release tube
 ldx #LO(laddr)
 ldy #HI(laddr)
 lda #tubeID
 and #&BF                   \ clear bit 6 of ID to release tube
 bit laddr+1
 bpl wget_tube_release
 lda #4                     \ if address is >= &8000 this is a language so send run command (and release tube)
.wget_tube_release
 jsr &406                   \ release tube

.wget_crd_end2
 lda sflag                  \ test if ROM file
 beq wget_crd_end_l1        \ jump if it's not a ROM file
 jsr wget_copy_file_to_swr  \ go copy the loaded file into sideways RAM
 jmp wget_close             \ goto the end of the routine
\ Store tape length in paged RAM
.wget_crd_end_l1
 lda uflag                  \ test if UEF file
 beq wget_close             \ it's not, jump
 jsr wget_context_switch_in
 lda #&FF
 sta pagereg
 lda sbufl
 sta &FDFE
 lda sbufh
 sta &FDFF
 jsr wget_context_switch_out

\ Close connection
.wget_close
 lda #14                    \ load close command code
 jsr wifidriver             \ close connection to server
 jmp call_claimed           \ end of command

\ Read an UEF file, in this version only non-compressed files are supported
\ and copied directly into the second paged RAM bank
\ Note to myself: this routine is also used for storing a sideways rom into
\ paged memory. 
.wget_read_uef_data
 jsr wget_test_end_of_data  \ test for end of data
 bcc wget_read_uef_end      \ jump if end of data is reached
 jsr read_buffer            \ read byte from input buffer
 jsr wget_write_buffer      \ store in memory
 inc sbufl                  \ increment tape length counter
 bne wget_read_uef_l1
 inc sbufh
.wget_read_uef_l1
 jsr dec_blocksize          \ decrement block size
 bne wget_read_uef_data     \ jump if more bytes to read
.wget_read_uef_end  
 jmp wget_crd_l1            \ return from subroutine

\ write data to the second paged RAM bank
.wget_write_buffer
 jsr wget_context_switch_in \ select second paged RAM bank
 sta pageram,y              \ store data
 iny                        \ increment pointer
 bne wget_write_buffer_end  \ check for end of page
 inc pagereg                \ end of page reached, increment page number
 lda pagereg                \ check for end of memory reached
 beq wget_write_buffer_full \ if 0 then wrapped, so buffer is full
.wget_write_buffer_end
 jsr wget_context_switch_out \ select primary paged RAM bank
 rts

.wget_write_buffer_full
 lda #14                    \ load close command code
 jsr wifidriver             \ close connection to server
 ldx #(error_buffer_full-error_table)
 jmp error

\ Note to myself: als straks bekend is of een bestand gecomprimeerd is of niet
\ dan kan ik de waarde voor mfb opslaan in een zeropage adres, dit inlezen en 
\ instellen met jsr set_bank_a.
.wget_context_switch_in
 pha                        \ save A
 lda pagereg                \ load page register
 sta load_addr+1            \ save it in zero page
 lda pr_r                   \ load second page register
 sta pagereg                \ activate it
 ldy pr_y
 jsr set_bank_1             \ activate the second paged RAM bank
 pla                        \ restore A
 rts                        \ return from subroutine

.wget_context_switch_out
 pha                        \ save A
 lda pagereg                \ load second page register
 sta pr_r                   \ save it in zero page
 sty pr_y
 lda load_addr+1            \ load primary page register
 sta pagereg                \ activate it
 jsr set_bank_0             \ activate the second paged RAM bank
 pla                        \ restore A
 rts                        \ return from subroutine

.protocols
 equs "TCP",&0D
 equs "SSL",&0D

.ports
 equs "80",&0D,&0D
 equs "443",&0D

.getcmd
 equs "GET /"
.http11
 equs " HTTP/1.1",&0D,&0A
 equs "HOST: "
.user_agent
 equb &0D,&0A
 equs "User-Agent: Elk WiFi WGET"
 equb &0D,&0A,&0D,&0A,&00


.ipd_needle equb "+IPD,"
.wget_search_ipd
 ldy #4                     \ load pointer 
.sipd0
 lda ipd_needle,y           \ load character from search string (= needle)
 sta heap,y                 \ store in workspace
 dey                        \ decrement pointer
 bpl sipd0                  \ jump if characters follow
 lda #5                     \ load needle length
.wget_search
 sta size                   \ store in workspace
 ldy #0                     \ reset pointer
.sipd1
 jsr wget_test_end_of_data  \ check for end of data
 bcc sipd5                  \ jump if no more data
 jsr read_buffer            \ read character from input buffer
 pha                        \ save it on stack
 jsr dec_blocksize          \ decrement block size
 pla                        \ restore character
 cmp heap,y                 \ compare with character in needle
 bne sipd3                  \ jump if not equal
\ CHARACTER MATCH
 iny                        \ character matches, increment pointer 
 cpy size                   \ test for end of needle
 bne sipd4                  \ not the end, continue for next character
 sec                        \ set carry for needle found
 rts                        \ return to calling routine
.sipd3
; CHARACTER DOES NOT MATCH, RESET POINTER
 ldy #0                     \ character does not match, reset pointer
.sipd4
 jsr wget_test_end_of_data  \ test if any data follows
 bcs sipd1                  \ jump if there is more data
.sipd5
 rts                        \ else return with carry cleared, i.e. needle not found

.crlf equb &0D,&0A,&0D,&0A
.wget_search_crlf
 ldy #3                     \ initialize pointer
.scrlf1
 lda crlf,y                 \ load character from search string (= needle)
 sta heap,y                 \ write to workspace
 dey                        \ decrement pointer
 bpl scrlf1                 \ jump if more characters to copy
 lda #4                     \ load needle length
 bne wget_search            \ jumps always

.wget_read_ipd
 lda #0                     \ reset block size
 sta blocksize
 sta blocksize+1
 sta blocksize+2
.read_ipd_loop
 jsr read_buffer            \ read character from input buffer
 cmp #':'                   \ test for end of IPD string
 beq read_ipd_end           \ jump if end of IPD string
 sec                        \ set carry for substraction
 sbc #'0'                   \ convert to hex value
 jsr mul10                  \ multiply the IPD value by 10 and add the last value read
 jmp read_ipd_loop          \ repeat for next character
.read_ipd_end
; lda blocksize+1:jsr printhex
; lda blocksize:jsr printhex
; jsr osnewl
 lda blocksize+1            \ load blocksize+1
 ora blocksize              \ ora with blocksize
 rts                        \ return with Z flag indicating the IPD value (zero or non-zero)


.mul10 \ MULTIPLY VALUE OF blocksize BY 10 AND ADD A
 pha
 asl blocksize
 lda blocksize
 rol blocksize+1
 rol blocksize+2
 ldy blocksize+1
 asl blocksize
 rol blocksize+1
 rol blocksize+2
 asl blocksize
 rol blocksize+1
 rol blocksize+2 
 clc
 adc blocksize
 sta blocksize
 tya
 adc blocksize+1
 sta blocksize+1
 lda blocksize+2
 adc #0
 sta blocksize+2
 clc
 pla
 adc blocksize
 sta blocksize
 lda blocksize+1
 adc #0
 sta blocksize+1
 lda blocksize+2
 adc #0
 sta blocksize+2
 rts

.wget_read_atm_header
 ldy #21                    \ load header length
.hdr1
 jsr dec_blocksize          \ decrement block size
 jsr read_buffer            \ read byte from input buffer
 sta heap,y                 \ write to workspace
 dey                        \ decrement pointer
 bpl hdr1                   \ jump if more bytes follow
 lda laddr                  \ test if there was an address on the command line
 ora laddr+1                \ that has presedence over the ATM load address
 bne hdr2                   \ jump if load address was specified
 lda heap+5                 \ set load address from heap
 sta laddr                  \ please mind that the ATM header is read backwards so
 lda heap+4                 \ low nibble is in a higher address than 
 sta laddr+1                \ the high nibble
.hdr2
 rts                        \ return from subroutine

.wget_read_apc_header
 ldy #16                    \ load header length
.hdr3
 jsr dec_blocksize          \ decrement block size
 jsr read_buffer            \ read byte from input buffer
 sta heap,y                 \ write to workspace
 dey                        \ decrement pointer
 bpl hdr3                   \ jump if more bytes follow
 lda laddr                  \ test if there was an address on the command line
 ora laddr+1                \ that has presedence over the APC load address
 bne hdr4                   \ jump if load address was specified
 lda heap+16                \ set load address from heap
 sta laddr                  \ please mind that the APC header is read backwards so
 lda heap+15                \ low nibble is in a higher address than 
 sta laddr+1                \ the high nibble
.hdr4
 rts                        \ return from subroutine


\ READ HTTP DATA UNTIL blocksize IS 0
\ DATA IS WRITTEN TO LOAD ADDRESS
.wget_read_http_data
 ldy #0                     \ clear index
 jsr wget_test_end_of_data  \ test for end of data
 bcc read_http_end          \ jump if end of data is reached
 jsr read_buffer            \ read byte from input buffer
 bit fflag
 bmi wget_read_tube_data    \ if flag set this is tube transfer
 sta (load_addr),y          \ store in memory
 inc load_addr              \ increment load address
 bne rhd1
 inc load_addr+1
 jmp rhd1
.wget_read_tube_data
 sta tubereg                \ write data to tube
 jsr read_http_end
 jsr read_http_end          \ delay to allow tube transfer
 
.rhd1
 jsr dec_blocksize          \ decrement block size
 bne wget_read_http_data    \ jump if more bytes to read
.read_http_end  
 rts                        \ return from subroutine

\ READ HTTP DATA UNTIL blocksize IS 0
\ Data is printed to screen.
.wget_dump_http_data
 jsr wget_test_end_of_data  \ test for end of data
 bcc read_http_end          \ jump if end of data is reached
 jsr read_buffer            \ read byte from input buffer
 bmi wget_dump_http_data_l1 \ if bit 7 is set then don't print it
 cmp newln                  \ compare to new line character
 beq wget_dump_newline      \ jump if new line character
 cmp #' '                   \ check for space
 bmi wget_dump_http_data_l1 \ don't print control codes
 jsr oswrch                 \ print the character
.wget_dump_http_data_l1
 jsr dec_blocksize          \ decrement block size
 bne wget_dump_http_data    \ jump if more bytes to read
 rts                        \ return from subroutine
.wget_dump_newline
 jsr osnewl                 \ move cursor to next line
 jmp wget_dump_http_data_l1 \ continue

\ Decrement blocksize. Blocksize is a 24 bit number but in WGET
\ we only use 16 bit values so we skip the third byte.
.dec_blocksize
 sec
 lda blocksize
 sbc #1
 sta blocksize
 cmp #&FF
 bne DBS1
 lda blocksize+1
 sbc #1
 sta blocksize+1
.DBS1 \ CHECK IF blocksize IS 0
 lda blocksize
 ora blocksize+1
 rts

.wget_test_end_of_data
 cpx datalen                \ compare pam index with data length LSB
 bne not_end_of_data        \ jump if not equal
 lda datalen+1              \ load MSB data length
 cmp pagereg                \ compare with pam register
 bne not_end_of_data        \ jump if not equal
 clc                        \ end of data, clear carry
 rts                        \ return with c=0 (no more data)
.not_end_of_data
 sec                        \ there is still data, set carry
 rts                        \ return with c=1 (data available)

.wget_set_default_load
 pha                        \ save accu
if __BBCMICRO__
 txa                        \ save x and y register also
 pha
 tya
 pha
 lda #&83                   \ perform OSBYTE &83: return current OSHWM
 jsr osbyte
 stx laddr                  \ save low byte
 sty laddr+1                \ save high byte
 pla                        \ restore x and y registers
 tay
 pla
 tax
else
 lda #&00                   \ low byte is always zero on the Atom
 sta laddr
 lda &12                    \ load high byte from zero page (?18)
 sta laddr+1
endif
 pla                        \ restore accu
 rts

.wget_http_status
 jsr wget_test_end_of_data  \ Read next character...
 bcc wget_http_status_end   \ ... as long as there is data
 jsr dec_blocksize
 jsr read_buffer            \ ... read the next byte
 cmp #' '                   \ check for space
 bne wget_http_status
 stx index                  \ save the buffer pointer
 jsr dec_blocksize
 jsr read_buffer            \ read the http status code (3 digits)
 sta heap                   \ store in heap
 jsr dec_blocksize
 jsr read_buffer
 sta heap+1
 jsr dec_blocksize
 jsr read_buffer
 sta heap+2
 lda heap                   \ now check for code 200
 cmp #'2'
 bne wget_http_status_err   \ if not 2 then jump to error
 lda #'0'                   \ load '0'
 cmp heap+1                 \ check second digit
 bne wget_http_status_err   \ jump if not '0'
 cmp heap+2                 \ check third digit
 bne wget_http_status_err   \ jump if not '0'
.wget_http_status_end
 rts                        \ end subroutine

.wget_http_status_err
 ldx index                  \ restore pointer to http status code
 jsr print_string           \ print the status code + message
 lda #14                    \ load close command code
 jsr wifidriver             \ close connection to server
 ldx #(error_http_status-error_table)
 jmp error                  \ throw an error

.wget_copy_file_to_swr      
 ldy #(wget_swramload_end-wget_swramload)  \ load index
.wget_copy_file_l1
 lda wget_swramload,y       \ read byte from copy routine
 sta heap,y                 \ copy to temporary workspace
 dey                        \ decrement index
 bpl wget_copy_file_l1      \ jump if not ready
 jsr wget_context_switch_in \ select second ram page
 jsr heap                   \ perform the copy action
 jsr wget_context_switch_out\ select first ram page
 rts                        \ end of routine

.wget_swramload
 lda shadow
 pha
 lda laddr        ; load RAM socket
 and #&0F         ; MASK HIGH NIBBLE
 sta shadow
 sta switch       ; select sideways RAM
 sta switch+1     ; needed for Palesar RAM board

\ Do your copy stuff here. This routine is copied outside of the ROM
\ and then called.
 ldx #&20
 stx pagereg
 ldx #&00
 stx zp+2
 lda #&80
 sta zp+3
 lda #&40
 sta zp+4
 ldy #0
.wget_swramload_l1
 lda pageram,x
 sta (zp+2),y
 cmp (zp+2),y                  ; Why doesn't this work with the
 bne wget_swramload_err        ; Palesar board ????
 inx
 iny
 bne wget_swramload_l1
 inc pagereg
 inc zp+3
 dec zp+4
 bne wget_swramload_l1

 pla
 sta shadow      ; RESTORE ROM
 sta switch
 sta switch+1    ; needed for Palesar RAM board
 rts

.wget_swramload_err
 pla
 sta shadow      ; RESTORE ROM
 sta switch
 sta switch+1    ; needed for Palesar RAM board
 brk
 equb 0
 equs "Not swram",&00

.wget_swramload_end
