AtomicRoland/BeebWiFi/(commit log)

2022-02-27 Bugfix in setserial port setup.
    [BeebWifi.asm, serial.asm]
2023-09-26 Update to v0.32: - add driver function 29 for setting time-out - OSWORD&65 returnx X and Y in &F0 / &F1 - Documentation updated
